delbel/handheld-i2c-analyzer/3dmodels/Assembly Attempt 1.SLDASM

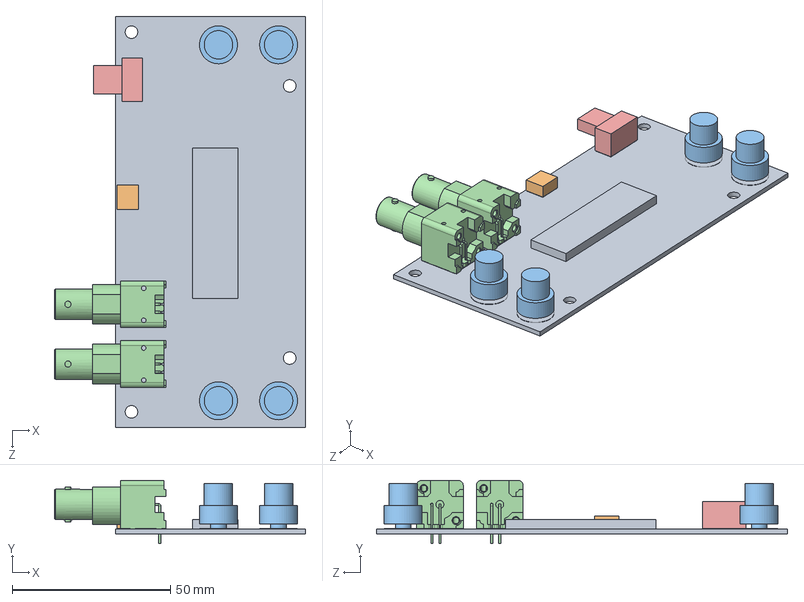
[picture p1: CAD file, 2011-04-30]
3dmodels/Assembly Attempt 1.SLDASM
79.3 x 20.0 x 130.0 mm
PCB
USB_Connector
Button x 4
BNC x 2
Switch
