delbel/handheld-i2c-analyzer/3dmodels/Button_Cap_Test.SLDASM

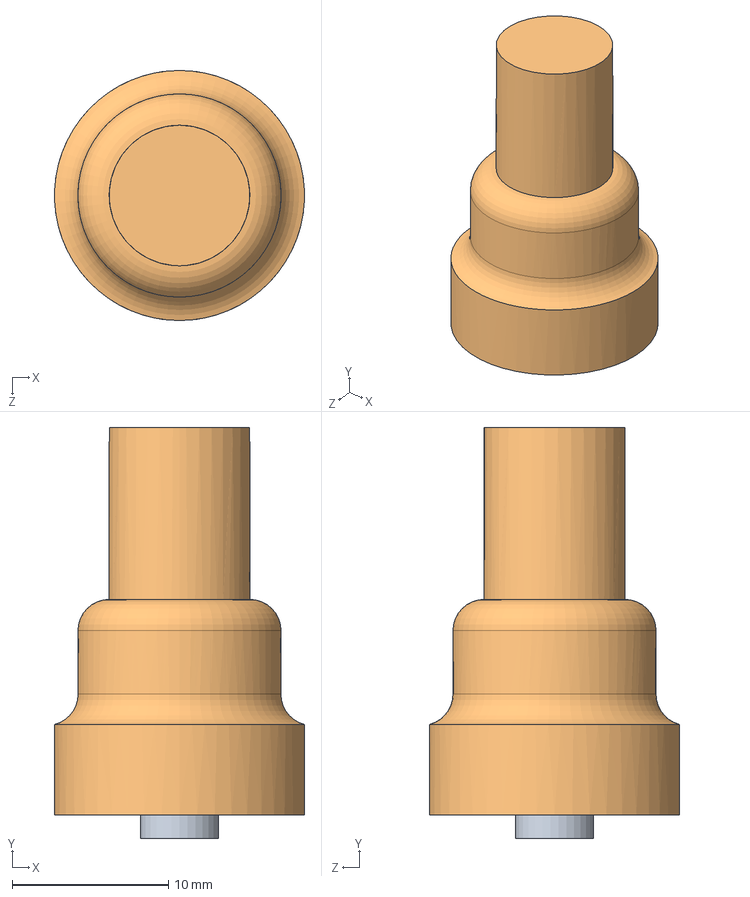
[picture p2: CAD file, 2011-04-21]
3dmodels/Button_Cap_Test.SLDASM
16.0 x 26.3 x 16.0 mm
Button
Button_Cap
