delbel/handheld-i2c-analyzer/3dmodels/Case/EnclosureBottom0.5.1.SLDPRT

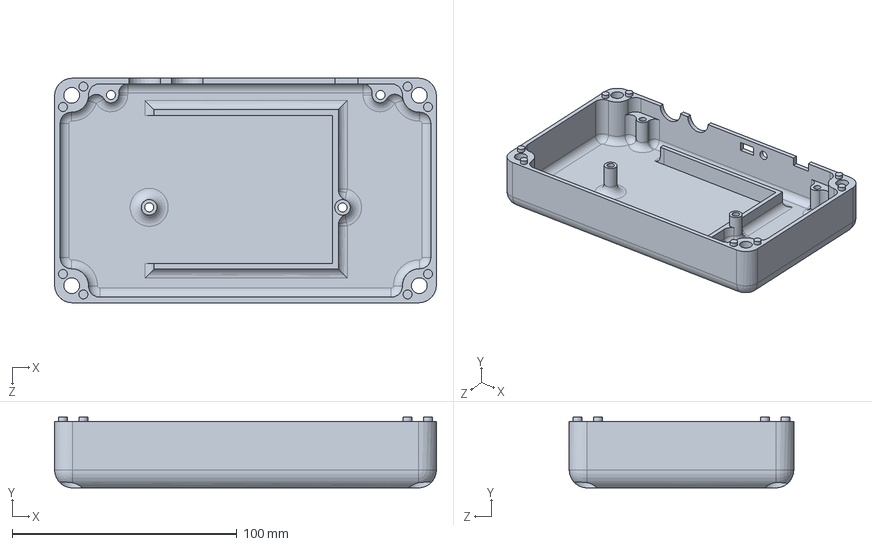
[picture p3: CAD file, 2011-04-30]
3dmodels/Case/EnclosureBottom0.5.1.SLDPRT
170.0 x 31.5 x 100.0 mm
