delbel/handheld-i2c-analyzer/3dmodels/PCB.SLDPRT

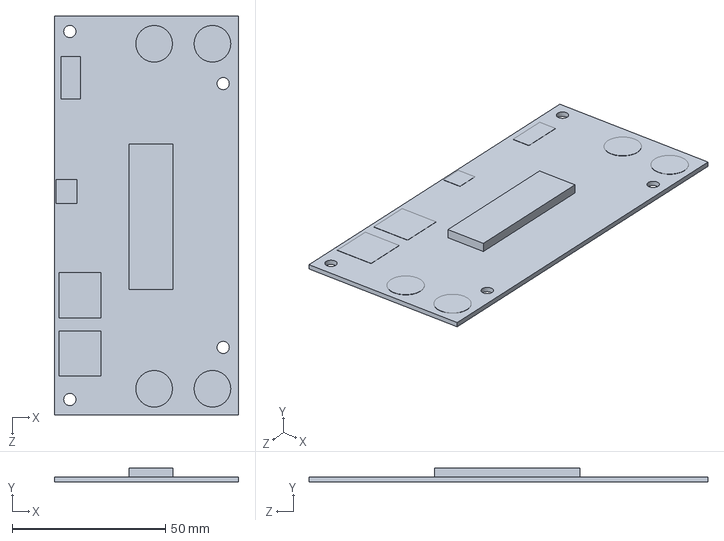
[picture p4: CAD file, 2011-04-30]
3dmodels/PCB.SLDPRT
60.0 x 4.57 x 130.0 mm
