delbel/handheld-i2c-analyzer/3dmodels/Case/EnclosureTop0.53.SLDPRT

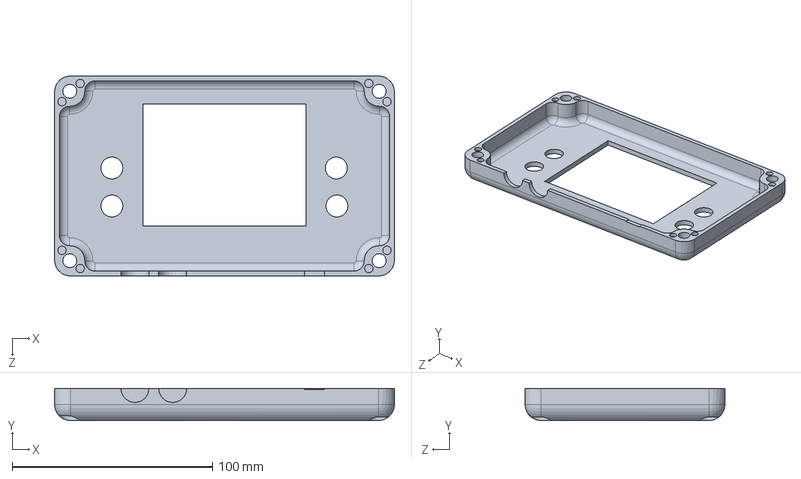
[picture p5: CAD file, 2011-04-30]
3dmodels/Case/EnclosureTop0.53.SLDPRT
170.0 x 16.0 x 100.0 mm
