delbel/handheld-i2c-analyzer/3dmodels/Case/Button_Cap.SLDPRT

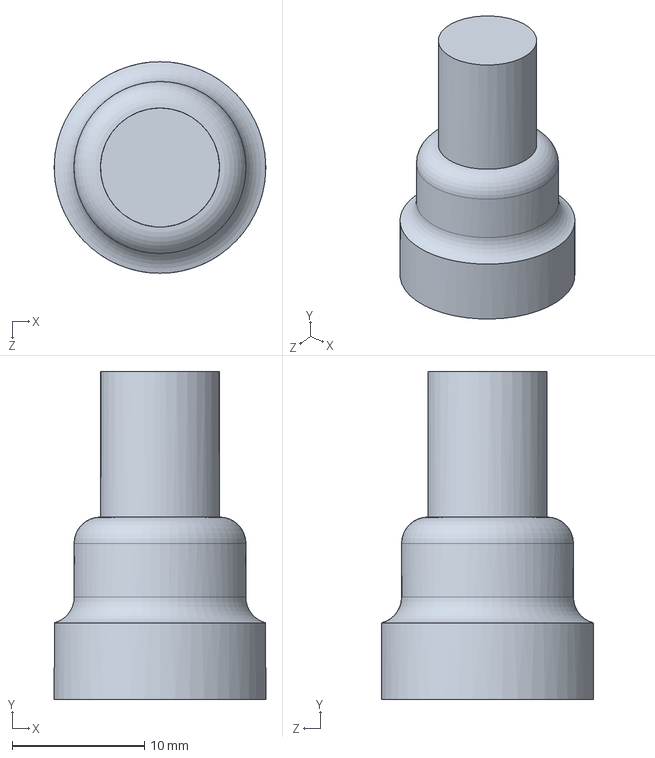
[picture p6: CAD file, 2011-04-21]
3dmodels/Case/Button_Cap.SLDPRT
16.0 x 24.8 x 16.0 mm
