delbel/handheld-i2c-analyzer/3dmodels/USB_Connector.SLDPRT

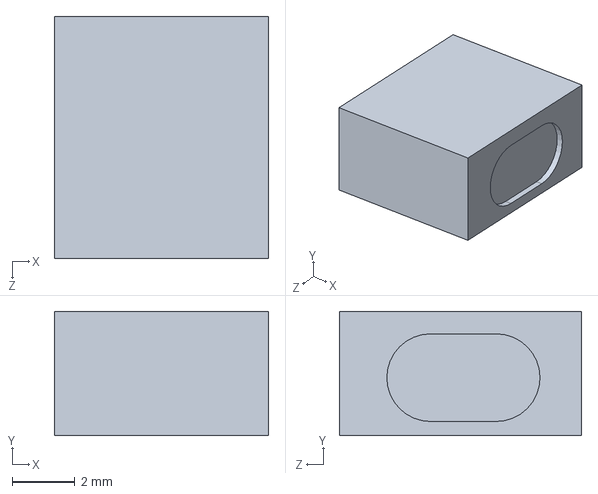
[picture p7: CAD file, 2011-04-13]
3dmodels/USB_Connector.SLDPRT
6.80 x 3.95 x 7.70 mm
