delbel/handheld-i2c-analyzer/3dmodels/Switch.SLDPRT

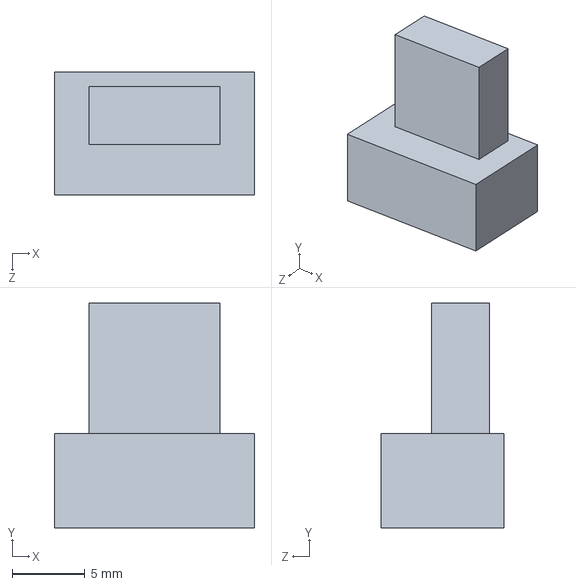
[picture p8: CAD file, 2011-04-13]
3dmodels/Switch.SLDPRT
13.8 x 15.5 x 8.50 mm
