delbel/handheld-i2c-analyzer/3dmodels/Battery.SLDPRT

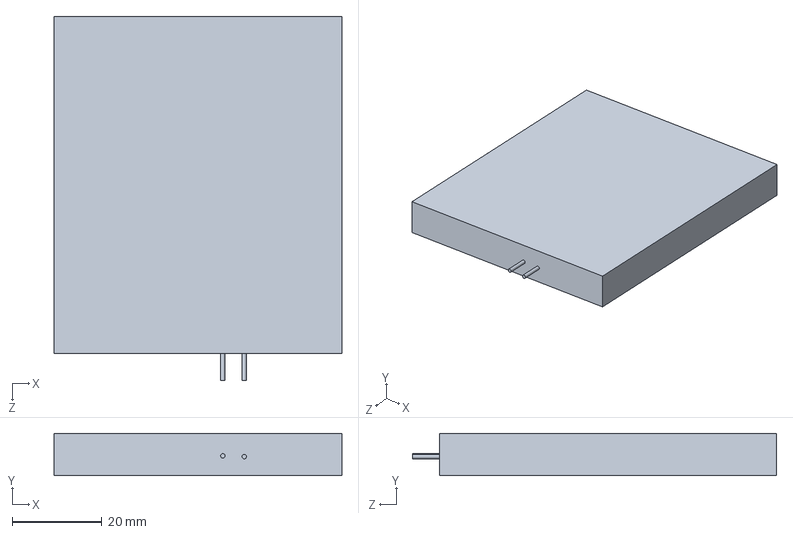
[picture p9: CAD file, 2011-04-13]
3dmodels/Battery.SLDPRT
64.0 x 9.40 x 81.0 mm
