delbel/handheld-i2c-analyzer/3dmodels/Screen.SLDPRT

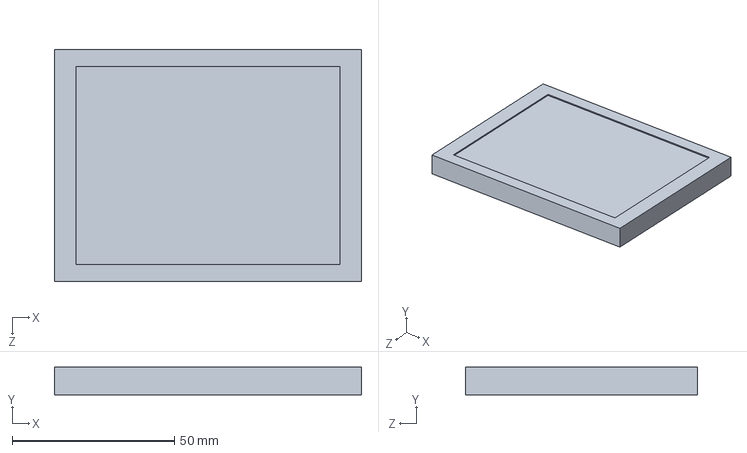
[picture p10: CAD file, 2011-04-13]
3dmodels/Screen.SLDPRT
94.7 x 8.60 x 71.7 mm
