delbel/handheld-i2c-analyzer/3dmodels/BNC.SLDPRT

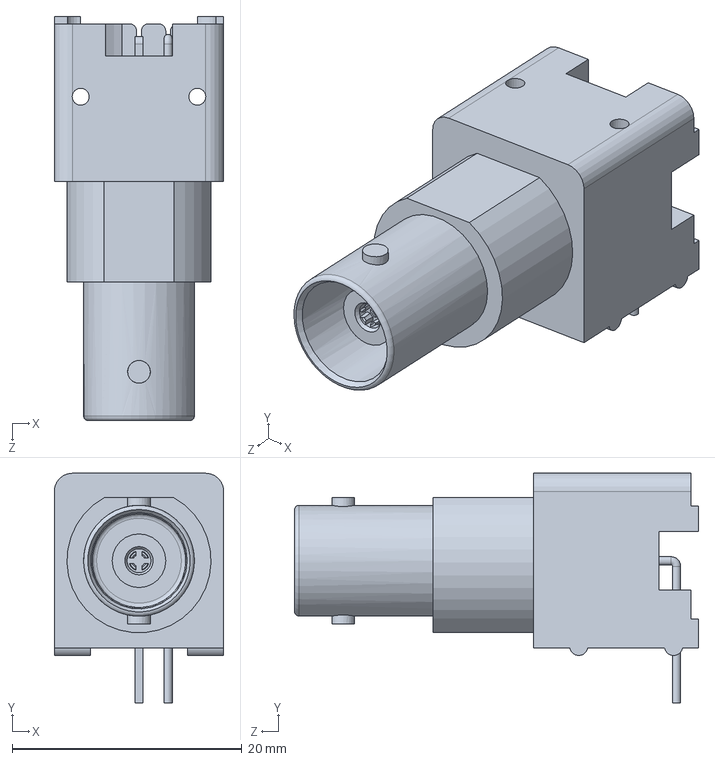
[picture p11: CAD file, 2011-04-13]
3dmodels/BNC.SLDPRT
14.8 x 20.0 x 35.2 mm
