delbel/handheld-i2c-analyzer/3dmodels/Button.SLDPRT

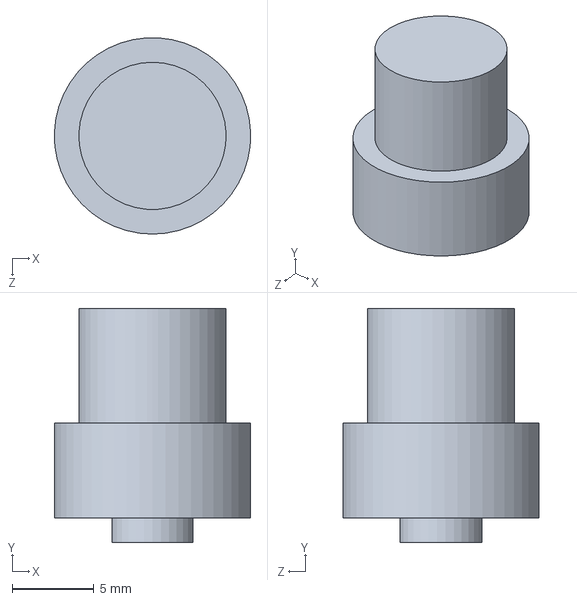
[picture p12: CAD file, 2011-04-13]
3dmodels/Button.SLDPRT
12.0 x 14.3 x 12.0 mm
