delbel/handheld-i2c-analyzer/pcb/proj18-sch.pdf

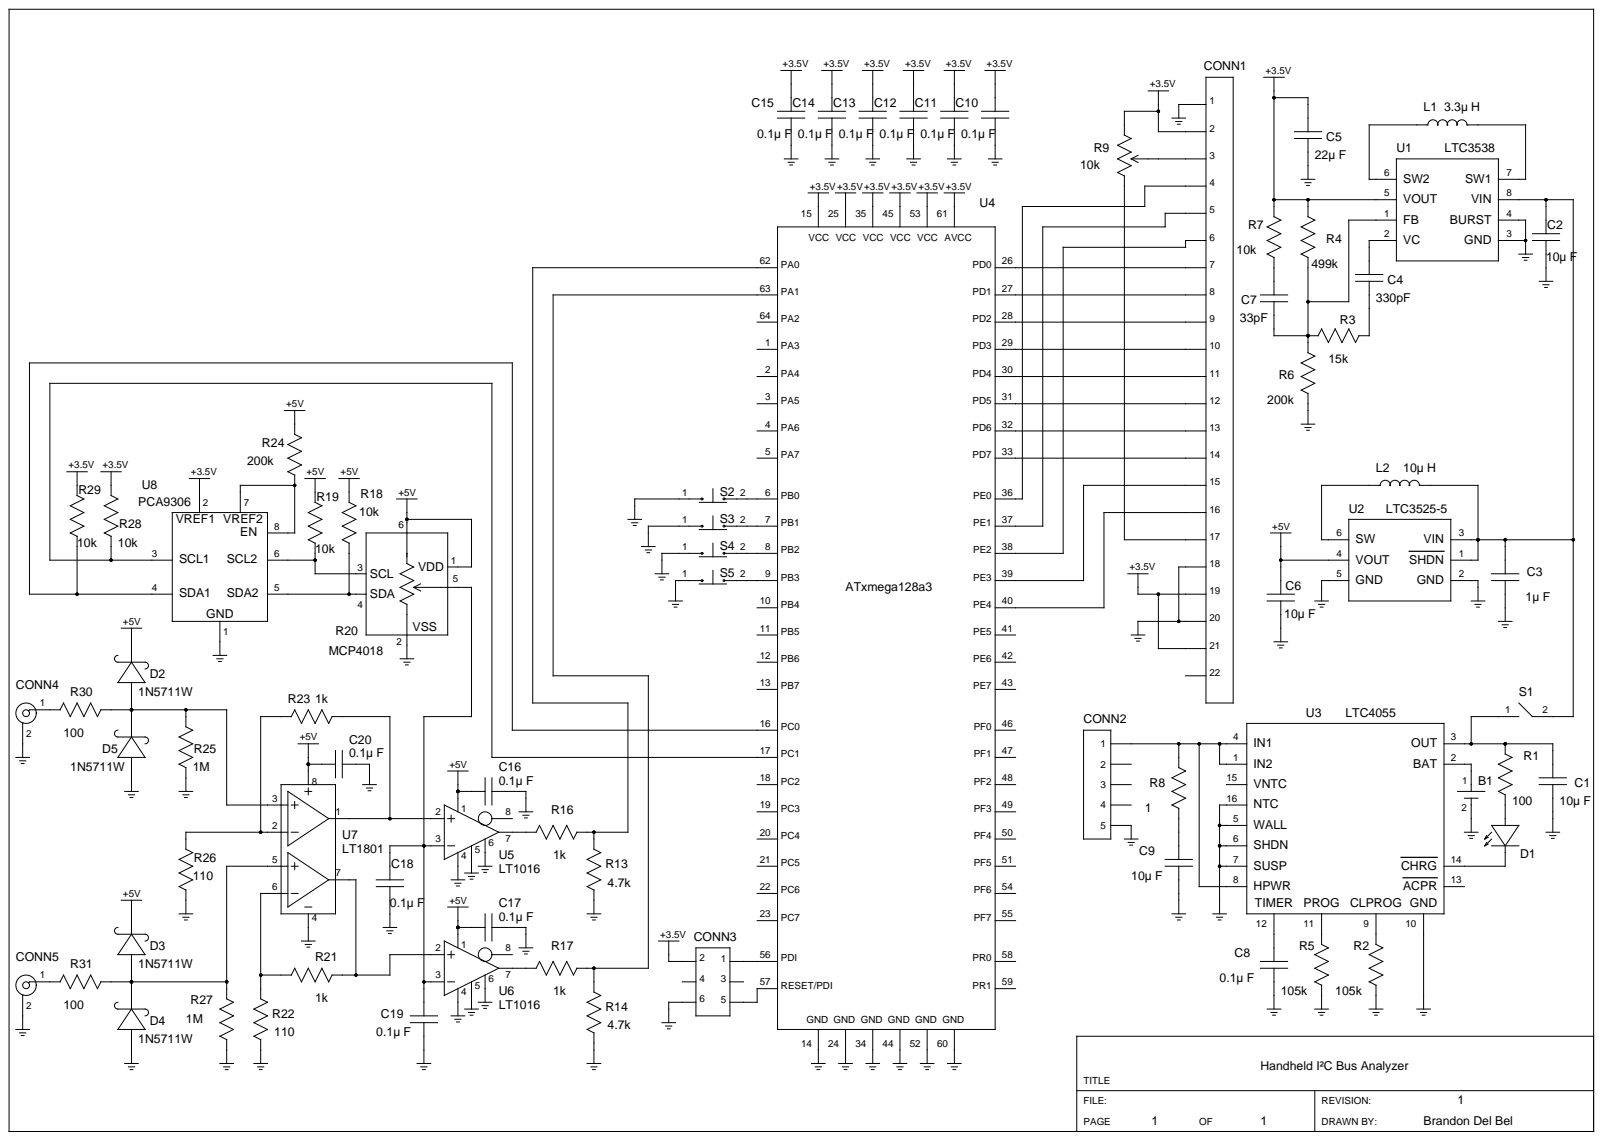
[picture p13: page 1]

Handheld I²C Bus Analyzer
