delbel/handheld-i2c-analyzer/(list of files, drawings)

Other design files:
pcb/proj18.pcb
