delbel/handheld-i2c-analyzer/(commit log)

2011-01-30 Initial Import of main.c with functionality to initialize the LCD screen using the driver: lcd-driver.c.
2011-02-01 Driver file to allow control of the digital pot with I2C.
2011-02-01 Made a few changes to main function (mostly added some defines). Added button-driver.c that handles normal button operation with stubs for the cancel interrupt functions.
2011-02-05 Both button interrupt functions implemented but not tested.
2011-02-06 Tested both types of button functionality. Corrected some bugs. Must make sure in main to enable interrupts and also the interrupts of each priority level you need.
    [button-driver.c, main.c]
2011-02-06 Fix include paths for Unix
    [button-driver.c, i2c-driver.c, lcd-driver.c, main.c]
2011-02-07 Added functions to write strings and invert strings at a given string, position, and length.
    [lcd-driver.c]
2011-02-07 Made small change to button-driver.c. Added start menu to main.c. This allows the user to select the logic level they want.
2011-02-12 Added assembly file and ATxmega128A3def.inc to the project.
2011-02-18 pull up FTDI pins on boot to fix bad behavior on battery power
    [main.c]
2011-02-19 Makefile changed to include .S assembly file in main.c. data_capture.S added and main.c changed to include the assembly function.
2011-02-19 Fixed bugs in i2c-driver.c and lcd-driver.c. Fixed makefile programming bug. Added some test code and made a few changes to main.c.
    [i2c-driver.c, lcd-driver.c, main.c]
2011-02-20 code that allows the allocated buffer to be used for the data in the assembly code.
2011-02-20 make it so data_capture() returns the updated Z pointer value. this can be used to calculate how much data was captured by subtracting from capture_data_start. also replaced tabs with spaces in assem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
    [main.c]
2011-02-21 implement cancel button
2011-02-21 disable cancel button before leaving state machine, not in isr
2011-02-22 fix cancel button
2011-02-22 clean up button-driver.c
2011-02-22 Added a folder and a main file for system testing with the atmega128 boards.
2011-02-22 clean up comments in state machine and fix bug in ack_nack
    [main.c]
2011-02-22 print more test lines
2011-02-23 started creating the main code to allow i2c conditions to be sent by buttons, changed makefile to compile correct program. added lcd driver files.
    [atmega-main.c, lcd.c, lcd.h]
2011-02-24 add accelerated scrolling and fix boundary check
    [main.c]
2011-02-25 Added code to send conditions out of the "I2C" bus on button presses. Still need to write code to output information to the display when each condition is sent. Also displays bus state on LED's.
2011-02-26 Added text to be displayed on LCD, added another button that sends 256 bytes of data to the user. Modified lcd.c to fix some timing issues with it.
    [atmega-main.c, lcd.c]
2011-02-27 fix incomplete transaction translation
    [main.c]
2011-02-27 Fixed start condition and fixed sending MSB first in send_byte.
    [atmega-main.c]
2011-02-27 fix bug in r91
    [main.c]
2011-02-28 Code for master mega128 board to transmit i2c messages and display what is sent.
2011-03-05 Interrupt version of slave and master demo code.
2011-03-05 reset logic level when entering main menu
    [main.c]
2011-04-10 add pcb stuff
    [proj18.pcb, proj18.sch]
2011-04-11 add BOM
2011-04-11 fix footprint for xmega
    [proj18.pcb]
2011-04-11 fix soldermask clearances
    [proj18.pcb]
2011-04-11 fix hole placement
    [proj18.pcb]
2011-04-13 fix dir name
    [Assembly Attempt 1.SLDASM, BNC.SLDPRT, Battery.SLDPRT, Button.SLDPRT, Enclosure Assembly.SLDASM, EnclosureBottom0.5.1.SLDPRT, PCB.SLDPRT, Screen.SLDPRT]
2011-04-21 Checking in new case models and updated cases and button caps.
    [Button_Cap.SLDPRT, Enclosure Assembly.SLDASM, EnclosureBottom0.5.1.SLDPRT, EnclosureTop0.53.SLDPRT]
2011-04-21 Button cap assembly.
    [Button_Cap_Test.SLDASM]
2011-04-21 Button driver updated to use internal pull ups.
2011-04-27 fix button state clearing
    [button-driver.c, main.c]
2011-04-30 New enclosure models with features discussed with Abdullah. See my ticket for list of all changes.
    [Assembly Attempt 1.SLDASM, Enclosure Assembly.SLDASM, EnclosureBottom0.5.1.SLDPRT, EnclosureTop0.53.SLDPRT, PCB.SLDPRT]
2011-04-30 Fixed a small issue with the bottom model.
    [Enclosure Assembly.SLDASM, EnclosureBottom0.5.1.SLDPRT]
